toyama238/rover/hardware/ESP_mac_list.xlsx

Number | Mac
1 | ac:27:6e:7c:e5:cc
2 | ac:27:6e:7f:1d:24
3 | ac:27:6e:7f:15:78
4 | ac:27:6e:7c:a5:58
5 | ac:27:6e:7f:6d:24
6 | ac:27:6e:7c:c2:98
7 | ac:27:6e:7e:11:84
8 | ac:27:6e:7c:15:e8
9 | ac:27:6e:7c:e0:ec
10 | ac:27:6e:7c:df:70
11 | ac:27:6e:7e:d8:b8
12 | ac:27:6e:7f:1f:a4
13 | ac:27:6e:7e:51:9c
14 | ac:27:6e:7e:fd:d8
15 | ac:27:6e:7e:23:60
16 | ac:27:6e:7f:8f:f0
17 | ac:27:6e:7d:fc:60
18 | ac:27:6e:7e:22:60
19 | ac:27:6e:7d:7a:8c
20 | ac:27:6e:7e:96:e0
