toyama238/rover/hardware/rover_parts_list.xlsx

Produkt | Kosten | Anzahl | Summe | Bezugsquelle |  | Insgesamt mn | pro Rover
Esp32C3 | 6.0333 | 1 | 6.0333 | Mouser (https://www.mouser.de/de/ProductDetail/Seeed-Studio/102010633?qs=sqEgtWRSLJ2E8a0kDnxKyg%3D%3D) |  | 28.1059
TC1508A | 0.44 | 1 | 0.44 | Christian (https://www.christians-shop.de/L298N-dual-H-Bruecke-Treiber-fuer-2-DC-Motoren-mit-PWM-Geschwindigkeit-oder-einem-Schrittmotor)
Li-ion safe | 0.69 |  | 0 | Christian (https://www.christians-shop.de/1S-37V-3A-Li-Ion-BMS-PCM-Batterie-Schutz-Board-PCM-fuer-18650-Li-Ion-Batterie)
Platine | 1.27 | 1 | 1.27
motor | 1.92 | 2 | 3.84 | Christian (https://www.christians-shop.de/Intelligentes-Roboter-Rad-65mm-Rad-Rad-mit-DC-Getriebe-Motor-fuer-Roboter-Smart-Car-und-Arduino)
TOF | 2.06 | 1 | 2.06 | Christian (https://www.christians-shop.de/GY-530-VL53L0X-Time-of-Flight-ToF-Flugzeit-Entfernungsmesssensor)
Optoreflexkoppler | 0.5 | 1 | 0.5 | Medicometer (https://www.ebay.de/itm/197034719340?itmmeta=01M2KN2B9K2YVVJHYWNACTKAA4)
Grüne LED | 0.094 | 1 | 0.094 | Mouser (https://www.mouser.de/de/ProductDetail/LITEON/LTL2R3KGD-EM?qs=sGAEpiMZZMvVL5Kk7ZYykddVguNoKifSaeen5TVKuXk%3D)
RGB LED | 0.2576 | 1 | 0.2576 | Mouser (https://www.mouser.de/de/ProductDetail/Adafruit/3094?qs=SV%252B0z0o3NTt%2F2YK7E3w5Rg%3D%3D)
Weiße LED | 0.114 |  | 0 | Mouser (https://www.mouser.de/de/ProductDetail/Inolux/INL-5AW30?qs=qSfuJ%252Bfl%2Fd4MUXtc27VAsw%3D%3D)
OLED Display | 2.31 |  | 0 |  | TODO
Akku | 0.5 |  | 0 | vorhanden
PLA | 2.04 | 1 | 2.04 | vorhanden
Kabel | 1 | 1 | 1 | vorhanden
Header | 2.16 | 1 | 2.16 | verschiedene, siehe headers.xlsx
Schalter | 0.48 | 1 | 0.48 | Reichelt (https://www.reichelt.de/de/de/shop/produkt/schiebeschalter-miniatur_loetanschluss_2x_um_sw-19976) | bissle unterdimensioniert
USB-B Buchse | 0.4 |  | 0 | Pollin (https://www.pollin.de/p/usb-b-einbaubuchse-900-450547)
USB-Kabel | 0.65 |  | 0 | Pollin (https://www.pollin.de/p/s-impuls-usb2-0-anschlusskabel-a-b-0-25-m-713198)
JST-Stecker XH 2pol für Akku auf Platine | 0.17 |  | 0 | Reichelt (https://www.reichelt.de/de/de/shop/produkt/jst_-_stiftleiste_gerade_1x2-polig_-_xh-185073)
JST-Buchse XH 2pol für Akku | 0.05 |  | 0 | Reichelt (https://www.reichelt.de/de/de/shop/produkt/jst_-_buchsengehaeuse_1x2-polig_-_xh-185085)
JST-Stecker 4pol für Li-ion safe (Platine) | 0.2 |  | 0 | Reichelt (https://www.reichelt.de/de/de/shop/produkt/jst_-_stiftleiste_gerade_1x4-polig_-_xh-185075) | optional, kann auch gelötet werden
JST-Buchse 4pol für Li-ion safe (Modul) | 0.07 |  | 0 | Reichelt (https://www.reichelt.de/de/de/shop/produkt/jst_-_buchsengehaeuse_1x4-polig_-_xh-185087) | optional, kann auch gelötet werden
Kontakte XH | 0.08 |  | 0 | Reichelt (https://www.reichelt.de/de/de/shop/produkt/jst_-_crimpkontakt_buchse_-_xh-185091) | sind erstmal vorhanden; gibt es auch bei Eckstein
Diode 1N5817 | 0.03 | 1 | 0.03 | Pollin (https://www.pollin.de/p/dioden-1n5817-1-a-20-v-10-stueck-140542)
Powerbank | 5.95 | 1 | 5.95 | https://www.pollin.de/p/logilink-powerbank-pa0316-10-000mah-schwarz-2-fach-usb-a-ausgang-273339
Karton | 0.41 | 1 | 0.41
Widerstand 4,7k | 0.006 | 2 | 0.012 | Reichelt (https://www.reichelt.de/de/de/shop/produkt/widerstand_kohleschicht_4_7_kohm_0207_250_mw_5_-1425)
Widerstand 15k | 0.006 | 2 | 0.012 | vorhanden
Widerstand 150 | 0.006 | 2 | 0.012 | Vorhanden (160Ohm)
Widerstand 100 | 0.005 | 2 | 0.01 | Reichelt (https://www.reichelt.de/de/de/shop/produkt/widerstand_kohleschicht_100_ohm_0207_250_mw_5_-1336)
Widerstand 1k | 0.006 | 2 | 0.012 | vorhanden
Widerstand 330 | 0.006 | 2 | 0.012 | vorhanden
Kondensator 100nF | 0.065 | 7 | 0.455 | Mouser (https://www.mouser.de/de/ProductDetail/Vishay-BC-Components/K104K15X7RF53K2?qs=csx2tJjGIuO338O2QcUpaQ%3D%3D)
Kondensator 1000µF | 0.5 |  | 0 | vorhanden
Pfostenbuchse 2*5 Flachband | 0.12 | 2 | 0.24 | Pollin (https://www.pollin.de/p/econ-connect-pfostenbuchse-fuer-flachbandleitung-rm-2-54-10-polig-451178)
Taster | 0.081 | 1 | 0.081 | Mouser (https://www.mouser.de/de/ProductDetail/Same-Sky/TS02-66-95-BK-160-LCR-D?qs=A6eO%252BMLsxmTlIRxhk6UZeg%3D%3D)
USB-Kabel ½ A gelötet | 0.32 | 1 | 0.32 | Pollin (https://www.pollin.de/p/s-impuls-usb2-0-anschlusskabel-a-b-0-25-m-713198)
ToF-Kabel | 0.375 | 1 | 0.375 | Pollin (https://www.pollin.de/p/steckboard-verbindungsleitungen-stecker-kupplung-40-polig-511158) | Christian nur 1/3 des Preises
