toyama238/rover/hardware/headers.xlsx

Anzahl Roboter | 30
 |  |  | Pollin |  |  |  | Reichelt |  |  |  | Christian |  |  |  | Eckstein
Bauteil | Anz | ges | EP | ges | Artikelnr | Anz | EP | ges | Artikelnr | Anz | EP | ges | Artikelnr | Anz | EP | ges | Artikelnr | Anz
Buchsenleiste für Motoren und ToF (ohne 5V), 1x4 | 2 | 60 | 0.15 | 0.3 | 451492 (https://www.pollin.de/p/connfly-electronic-buchsenleiste-vergoldet-1x-4-polig-451492) | 60 | 0.81 | 1.62 | BKL 10120946 (https://www.reichelt.de/de/de/shop/produkt/buchsenleiste_2_54mm_1x4_gerade-266671) |  |  | 0 | unklar |  |  | 0 | -
Buchsenleiste für Motortreiber, 1x2 | 5 | 150 | 0.1 | 0.5 | 451552 (https://www.pollin.de/p/econ-connect-buchsenleiste-vergoldet-1x-2-polig-451552) | 150 | 0.69 | 3.45 | BKL 10120944 (https://www.reichelt.de/de/de/shop/produkt/buchsenleiste_2_54mm_1x2_gerade-266669) |  |  | 0 | unklar |  |  | 0 | -
Buchsenleiste für XIAO, 1x7 | 2 | 60 | 0.15 | 0.3 | 451498 (*) (https://www.pollin.de/p/connfly-electronic-buchsenleiste-vergoldet-1x-20-polig-451498) | 30 |  | 0 | teuer |  | 0.026 | 0.052 | 214 (*) (https://www.christians-shop.de/40-Pin-Stiftleiste-Pinleiste-254mm-weiblich-einfach) | 8 | 0.29 | 0.58 | ZB03013 (https://eckstein-shop.de/Buchsenleiste-1x7Pin-Gerade-Standard-EN) | 60
Crimpgehäuse 1x2 | 4 | 120 |  | 0 | - |  |  | 0 | unklar |  | 0.174 | 0.696 | 100407 incl. Kontakte (https://www.christians-shop.de/620-teiliges-Set-DuPont-Steckverbindungen-Stecker-Buchsen-Jumper-1x1-bis-2x6-Pin-inkl-weiblicher-und-maennlicher-Quetschverbind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) | 3 | 0.07 | 0.28 | ZB00003-002 (https://eckstein-shop.de/22C54mmDupontJumperCrimpConnectorHousingStecker1x2Pin25PackEN) | 5
Crimp-Pins, männlich | 4 | 120 |  | 0 | - |  |  | 0 | unklar |  | 0 | 0 | incl |  | 0.0269 | 0.1076 | PO1931 (https://eckstein-shop.de/MaleCrimpPinsfor0122Housings100-PackEN) | 2
Crimp-Pins, weiblich | 4 | 120 |  | 0 | - |  |  | 0 | unklar |  | 0 | 0 | incl |  | 0.0195 | 0.078 | PO1930 (https://eckstein-shop.de/FemaleCrimpPinsfor0122Housings100-PackEN) | 2
Stiftleiste für Opto-Sensor, 2x10 | 1 | 30 | 0.125 | 0.125 | 452918 (https://www.pollin.de/p/stiftleiste-2-x-32-2-54-mm-gerade-0-8-au-gold-5-stueck-452918) | 1 |  | 0 | egal |  |  | 0 | egal |  |  | 0 |  |  | vorhanden!
Stiftleiste für LEDs und Treiber, 1x2 | 7 | 210 | 0.0276 | 0.1932 | 451550 (https://www.pollin.de/p/stiftleiste-vergoldet-1x-20-polig-10-stueck-451550) | 3 |  | 0 | egal |  |  | 0 | egal |  |  | 0 |  |  | vorhanden!
(*): unpassend, muss aufwändig getrennt werden
Summe |  |  |  | 1.1182 |  |  |  |  |  |  |  |  |  |  |  | 1.0456 |  |  | 2.1638
