toyama238/rover/3D-parts/STL/Main.stl

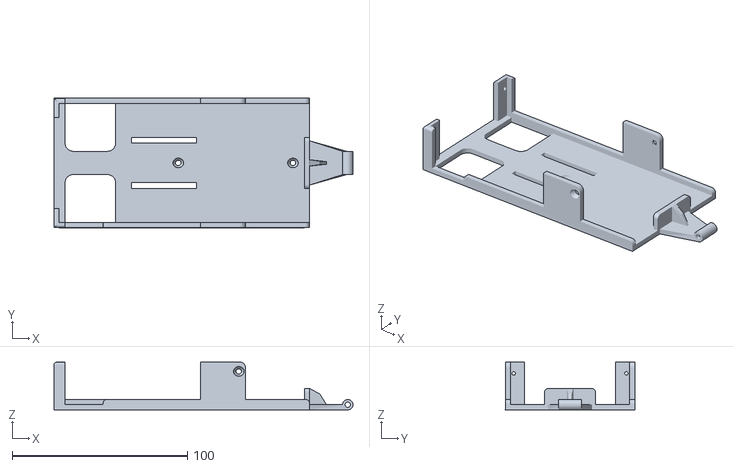
[picture p4: CAD file, 2026-10-12]
3D-parts/STL/Main.stl
170.8 x 74.0 x 27.4
