toyama238/rover/3D-parts/STL/ToF_Holder.stl

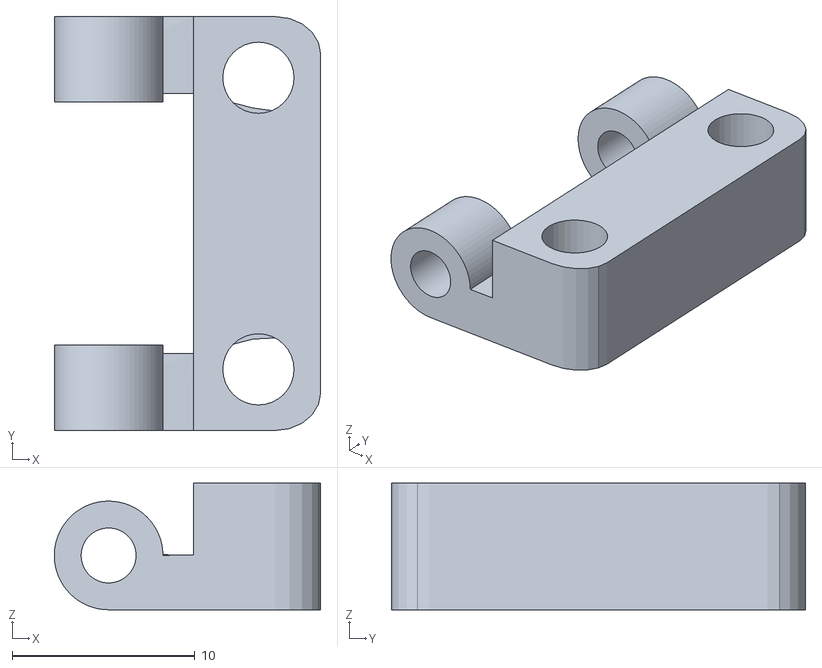
[picture p5: CAD file, 2026-10-13]
3D-parts/STL/ToF_Holder.stl
14.6 x 22.7 x 6.94
