toyama238/rover/3D-parts/STL/Foot.stl

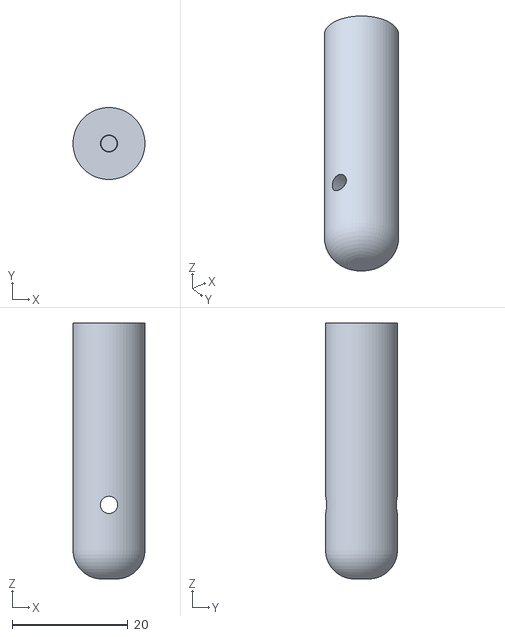
[picture p6: CAD file, 2026-10-12]
3D-parts/STL/Foot.stl
12.4 x 12.4 x 44.3
