toyama238/rover/3D-parts/STL/Motor_Holder.stl

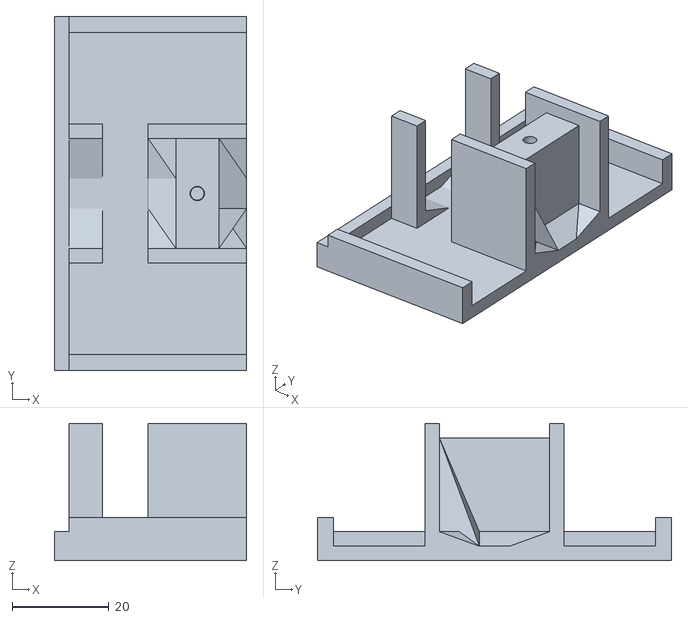
[picture p7: CAD file, 2026-10-12]
3D-parts/STL/Motor_Holder.stl
39.8 x 73.1 x 28.4
