toyama238/rover/3D-parts/STL/PCB_Holder.stl

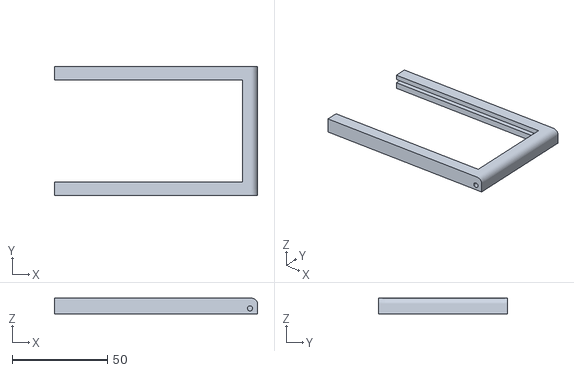
[picture p8: CAD file, 2026-10-12]
3D-parts/STL/PCB_Holder.stl
106.5 x 67.8 x 8.24
