toyama238/rover/3D-parts/STL/Stick.stl

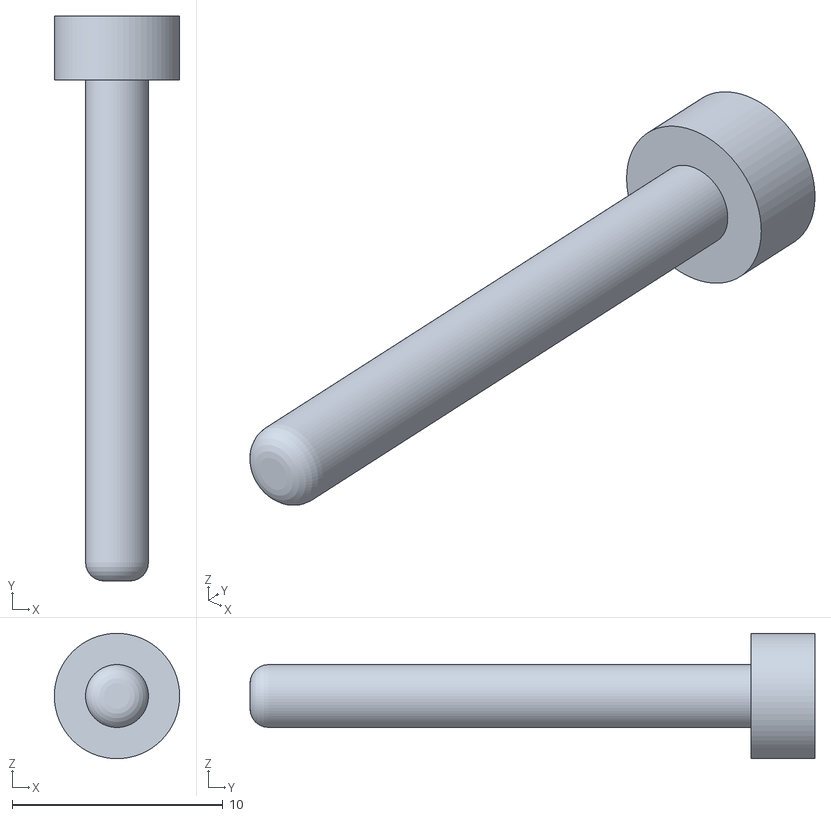
[picture p9: CAD file, 2026-10-12]
3D-parts/STL/Stick.stl
5.96 x 26.8 x 5.96
