toyama238/rover/3D-parts/STL/ToF_Header.stl

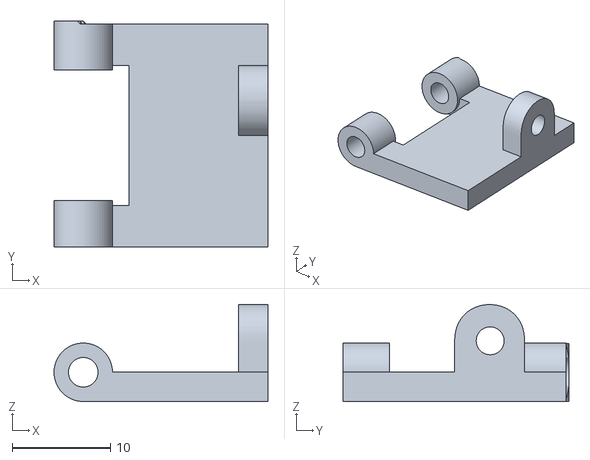
[picture p10: CAD file, 2026-10-12]
3D-parts/STL/ToF_Header.stl
21.8 x 23.0 x 9.88
