toyama238/rover/3D-parts/STL/PCB_Close.stl

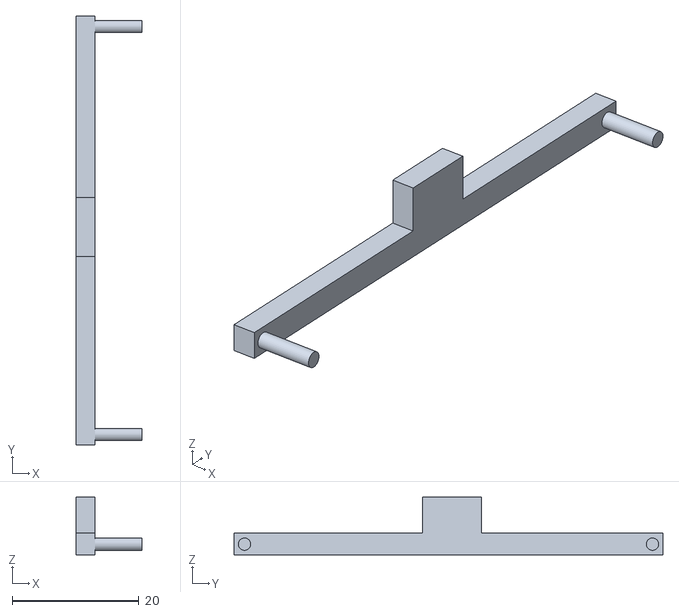
[picture p11: CAD file, 2026-10-11]
3D-parts/STL/PCB_Close.stl
10.4 x 67.8 x 9.16
