toyama238/rover/3D-parts/STL/Motor_Connector.stl

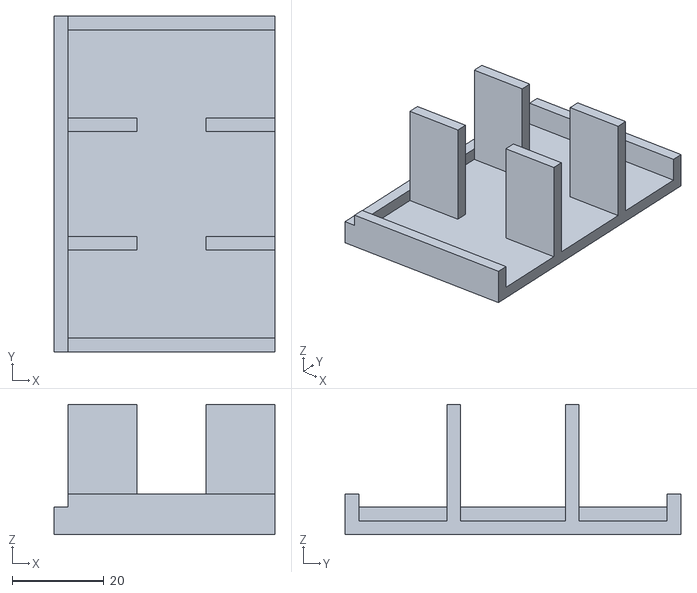
[picture p12: CAD file, 2026-10-11]
3D-parts/STL/Motor_Connector.stl
48.0 x 73.1 x 28.4
