toyama238/rover/(list of files, cad)

Other CAD files:
3D-parts/rover.blend
