toyama238/rover/menu/TODO.md

# TODOs für die Schule
- Plakat
- Info-Flyer (oder einfach Plakat?)
- Teile zusammenstellen
- Micropython auf Mikrocontroller aufspielen und einfaches Testprogramm

# TODOs für die Makerfaire
- Crawler und FPV-Kamera testen
- Crawler-Akkus laden

# Kartong Inhalt
- Esp32-C3 +
- Powerbank +
- ToF-Sensor +
- ToF-Kabel +
- (Scheinwerfer Led (2x))
- Analog sensor +
- Senkschrauben (4x) +
- bolzen-schraube M3x30 +
- mutter (2x) M3 +
- Kabelbinder (2x) +
- PCB, Motortreiber +
- Motoren (2x) +
- Räder (2x) +
- 3D Parts (5-Teile) +
