toyama238/rover/(commit log)

2026-09-15 upload parts_list
    [rover_parts_list.xlsx]
2026-09-16 Stückliste ergänzt
    [rover_parts_list.xlsx]
2026-09-22 rearanged file structure
    [rover.blend, rover_parts_list.xlsx]
2026-09-22 removed unused data
    [rover_parts_list.xlsx]
2026-09-22 reworked some stuff not important
    [rover.blend]
2026-09-22 added folders
    [rover.blend]
2026-09-26 some major changes, added more code, reworked on the schematic and the PCB, added new pictures
    [rover.blend, rover_parts_list.xlsx]
2026-09-27 parts list updated
    [rover_parts_list.xlsx]
2026-10-06 Listen aktualisiert
    [headers.xlsx, rover_parts_list.xlsx]
2026-10-11 Edited 3D parts and added stl files for 3D print
2026-10-12 add stl
2026-10-14 edited software, added example code for sensors, led, and motors, added list of mac adresses
2026-10-15 edited menu und ignore file
2026-10-16 added led description in hardware
2026-10-16 reset calibration value fro -8 to 0
